DylanLin478/esp32-s3-meter/Schematic/Microcontroller/Screenshot 2026-11-06 132502.png

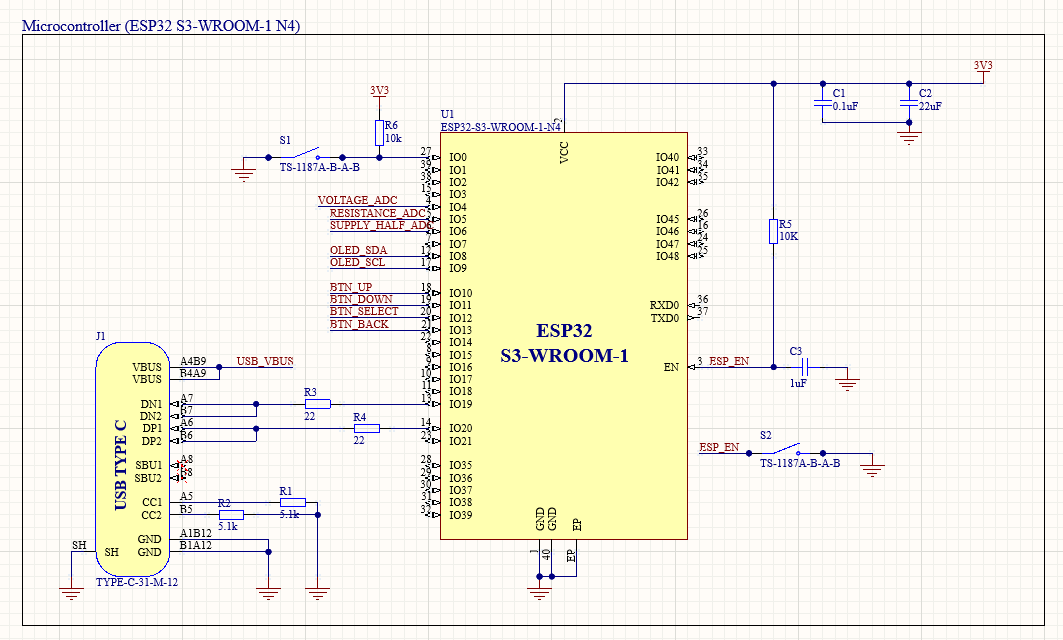
Schematic/Microcontroller/Screenshot 2026-11-06 132502.png
