DylanLin478/esp32-s3-meter/Bill_of_Materials_Download(Excel).xlsx

DigiKey - Shopping Cart
Index | Quantity | Part Number | Manufacturer Part Number | Description | Unit of Measure | Customer Reference | Available | Backorder | Unit Price | Extended Price USD
1 | 6 | CKN12220-1-ND | PTS526SM15SMTR2 LFS | SWITCH TACTILE SPST-NO 0.05A 12V |  |  | 6 | 0 | 0.16 | 0.96
2 | 10 | 1292-1565-1-ND | 0805B104K160CT | CAP CER 0.1UF 16V X7R 0805 |  |  | 10 | 0 | 0.032 | 0.32
3 | 1 | 1276-2931-1-ND | CL21B105KOFNNWE | CAP CER 1UF 16V X7R 0805 |  |  | 1 | 0 | 0.11 | 0.11
4 | 2 | 587-2980-1-ND | EMK212ABJ106KD-T | CAP CER 10UF 16V X5R 0805 |  |  | 2 | 0 | 0.21 | 0.42
5 | 4 | 1276-CL21A226MQQNNNECT-ND | CL21A226MQQNNNE | CAP CER 22UF 6.3V X5R 0805 |  |  | 4 | 0 | 0.17 | 0.68
6 | 1 | 160-1436-1-ND | LTST-C190KRKT | LED RED CLEAR CHIP SMD |  |  | 1 | 0 | 0.14 | 0.14
7 | 1 | 2073-USB4105-GF-ACT-ND | USB4105-GF-A | CONN RCP USB2.0 TYP C 16P SMD RA |  |  | 1 | 0 | 0.8 | 0.80
8 | 2 | 732-10955-ND | 691137710002 | TERM BLK 2POS SIDE ENTRY 5MM PCB |  |  | 2 | 0 | 0.38 | 0.76
9 | 1 | 455-B2B-PH-SM4-TBCT-ND | B2B-PH-SM4-TB | CONN HEADER SMD 2POS 2MM |  |  | 1 | 0 | 0.47 | 0.47
10 | 1 | 541-1267-1-ND | IHLP2020CZER1R5M01 | FIXED IND 1.5UH 7.2A 20.7 MOHM |  |  | 1 | 0 | 1.17 | 1.17
11 | 1 | DMG3415UDICT-ND | DMG3415U-7 | MOSFET P-CH 20V 4A SOT23-3 |  |  | 1 | 0 | 0.52 | 0.52
12 | 2 | CR0805-FX-5101ELFCT-ND | CR0805-FX-5101ELF | RES SMD 5.1K OHM 1% 1/8W 0805 |  |  | 2 | 0 | 0.1 | 0.20
13 | 2 | 311-22.0CRCT-ND | RC0805FR-0722RL | RES 22 OHM 1% 1/8W 0805 |  |  | 2 | 0 | 0.1 | 0.20
14 | 10 | 311-10.0KCRCT-ND | RC0805FR-0710KL | RES 10K OHM 1% 1/8W 0805 |  |  | 10 | 0 | 0.038 | 0.38
15 | 1 | 311-47.0KCRCT-ND | RC0805FR-0747KL | RES 47K OHM 1% 1/8W 0805 |  |  | 1 | 0 | 0.1 | 0.10
16 | 3 | 311-1.00KCRCT-ND | RC0805FR-071KL | RES 1K OHM 1% 1/8W 0805 |  |  | 3 | 0 | 0.1 | 0.30
17 | 1 | 311-33.0KCRCT-ND | RC0805FR-0733KL | RES 33K OHM 1% 1/8W 0805 |  |  | 1 | 0 | 0.1 | 0.10
18 | 2 | P10KDACT-ND | ERA-6AEB103V | RES SMD 10K OHM 0.1% 1/8W 0805 |  |  | 2 | 0 | 0.1 | 0.20
19 | 1 | 401-1999-1-ND | JS102011SAQN | SWITCH SLIDE SPDT 300MA 6V |  |  | 1 | 0 | 0.9 | 0.90
20 | 1 | 1965-ESP32-S3-WROOM-1-N4CT-ND | ESP32-S3-WROOM-1-N4 | RF TXRX MODULE BT PCB TRACE SMD |  |  | 1 | 0 | 5.21 | 5.21
21 | 1 | 296-37448-1-ND | TPS63021DSJT | IC REG BUCK BST 3.3V 3.5A 14VSON |  |  | 1 | 0 | 5.67 | 5.67
22 | 1 | Proto Supplies | Proto Supplies | OLED 1.3″ 128×64 I2C Blue Display |  |  | 1 | 0 | 5.95 | 5.95
