DylanLin478/esp32-s3-meter/(list of files, drawings)

Other design files:
Esp32 PCB.PcbDoc
Schematic/Sheet1-meter-OLED-buckboost.SchDoc
