DylanLin478/esp32-s3-meter/(commit log)

2026-11-06 Document meter goals, proposed battery architecture, and validation roadmap
    Expanded project details, goals, and documentation roadmap for the ESP32-S3 voltage and resistance meter.
2026-11-06 Document power supply revision in README
    Added details about the power supply revision from LDO to dual buck converters, including schematic and design considerations.
2026-11-06 Add November 6 schematic development screenshots
2026-11-06 Document OLED meter architecture and November 6 design findings
    Updated project description, goals, and design details for the ESP32-S3 voltage and resistance meter. Revised power architecture and components, added schematic blocks, and outlined documentation roadmap.
2026-11-06 Rename Screenshot 2026-11-06 132502.png to esp32-s3-usb-programming-schematic.png
2026-11-06 Rename Screenshot 2026-11-06 132506.png to oled-display-navigation-buttons-schematic.png
2026-11-06 Rename Screenshot 2026-11-06 132453.png to voltage-resistance-adc-front-end-schematic.png
2026-11-06 Rename voltage-resistance-adc-front-end-schematic.png to Voltage and Resistance Meter
2026-11-06 Rename Screenshot 2026-11-06 132510.png to Buck Boost & Battery Terminal
2026-11-06 Rename esp32-s3-usb-programming-schematic.png to ESP32 & USB_C
2026-11-06 Rename oled-display-navigation-buttons-schematic.png to OLED Display % Buttons
2026-11-06 Rename Schematic-v1-LDO.png to LDO (Discontinued & revised)
2026-11-06 Create Schematic
2026-11-06 Rename Voltage and Resistance Meter to Voltage & Resistance Meter
2026-11-06 Rename OLED Display % Buttons to OLED Display & Buttons
2026-11-06 Rename Screenshot 2026-11-06 144633.png to Overall Schematic Rev 1
2026-11-06 Create Overall Schematic.md
2026-11-06 Add Buck-Boost Converter section to schematic
    Added a section for the Buck-Boost Converter with a schematic image and design explanation.
2026-11-06 Update Overall Schematic.md
2026-11-06 Update schematic image link in documentation
2026-11-06 Rename Overall Schematic Rev 1 to Overall Schematic Rev 1.png
2026-11-06 Fix image path for overall schematic
2026-11-06 Rename Schematic-v1-LDO.png to LDO (Discontinued and Revised).png
2026-11-07 Rename Overall Schematic Rev 1.png to Overall_Schematic_Rev 1.png
2026-11-07 Rename Screenshot 2026-11-06 194243.png to Display & Buttons
2026-11-07 Rename Screenshot 2026-11-06 194248.png to Buck Boost (3v7 to 3v3)
2026-11-07 Rename Buck Boost (3v7 to 3v3) to Buck Boost (3v7 to 3v3).png
2026-11-07 Rename Display & Buttons to Display & Buttons.png
2026-11-07 Rename Screenshot 2026-11-06 194300.png to Voltage & Resistance Meters.png
2026-11-08 Revise README to reflect current project status
    Removed outdated project details and design updates.
2026-11-09 Rename Esp32 PCB.PcbDoc to Esp32_PCB_Download(ALTIUM)
    [Esp32 PCB.PcbDoc]
2026-11-09 Document hardware design decisions, image gallery, and validation plan
    Build the main README into a hardware portfolio case study with all 13 project images, LDO versus buck-boost tradeoffs, measurement equations, resistor tolerance analysis, capacitor selection criteria, and an explicit awaiting-parts status.
